R41NFR0G/Microbial-Source-Tracking/Diagrams/diagram of system.png

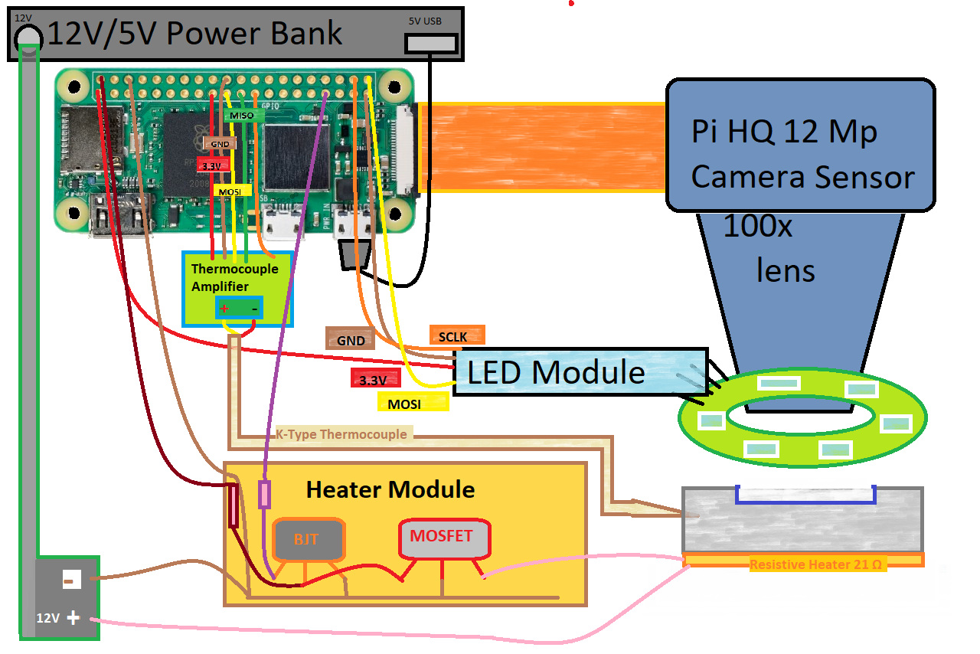
Diagrams/diagram of system.png
