R41NFR0G/Microbial-Source-Tracking/Diagrams/RinglightSchematic.pdf

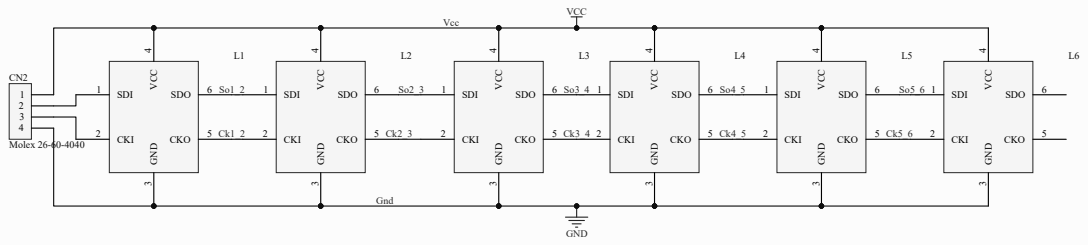
[picture p53: page 1]
Title; Size; Number; Revision; Letter; Date:; Sheet of; File:; led.SchDoc; Drawn By:; SDI 1; CKI 2; GND; CKO; SDO VCC; VCC; Molex 26-60-4040; Vcc; Gnd
