R41NFR0G/Microbial-Source-Tracking/Diagrams/RinglightPCB.pdf

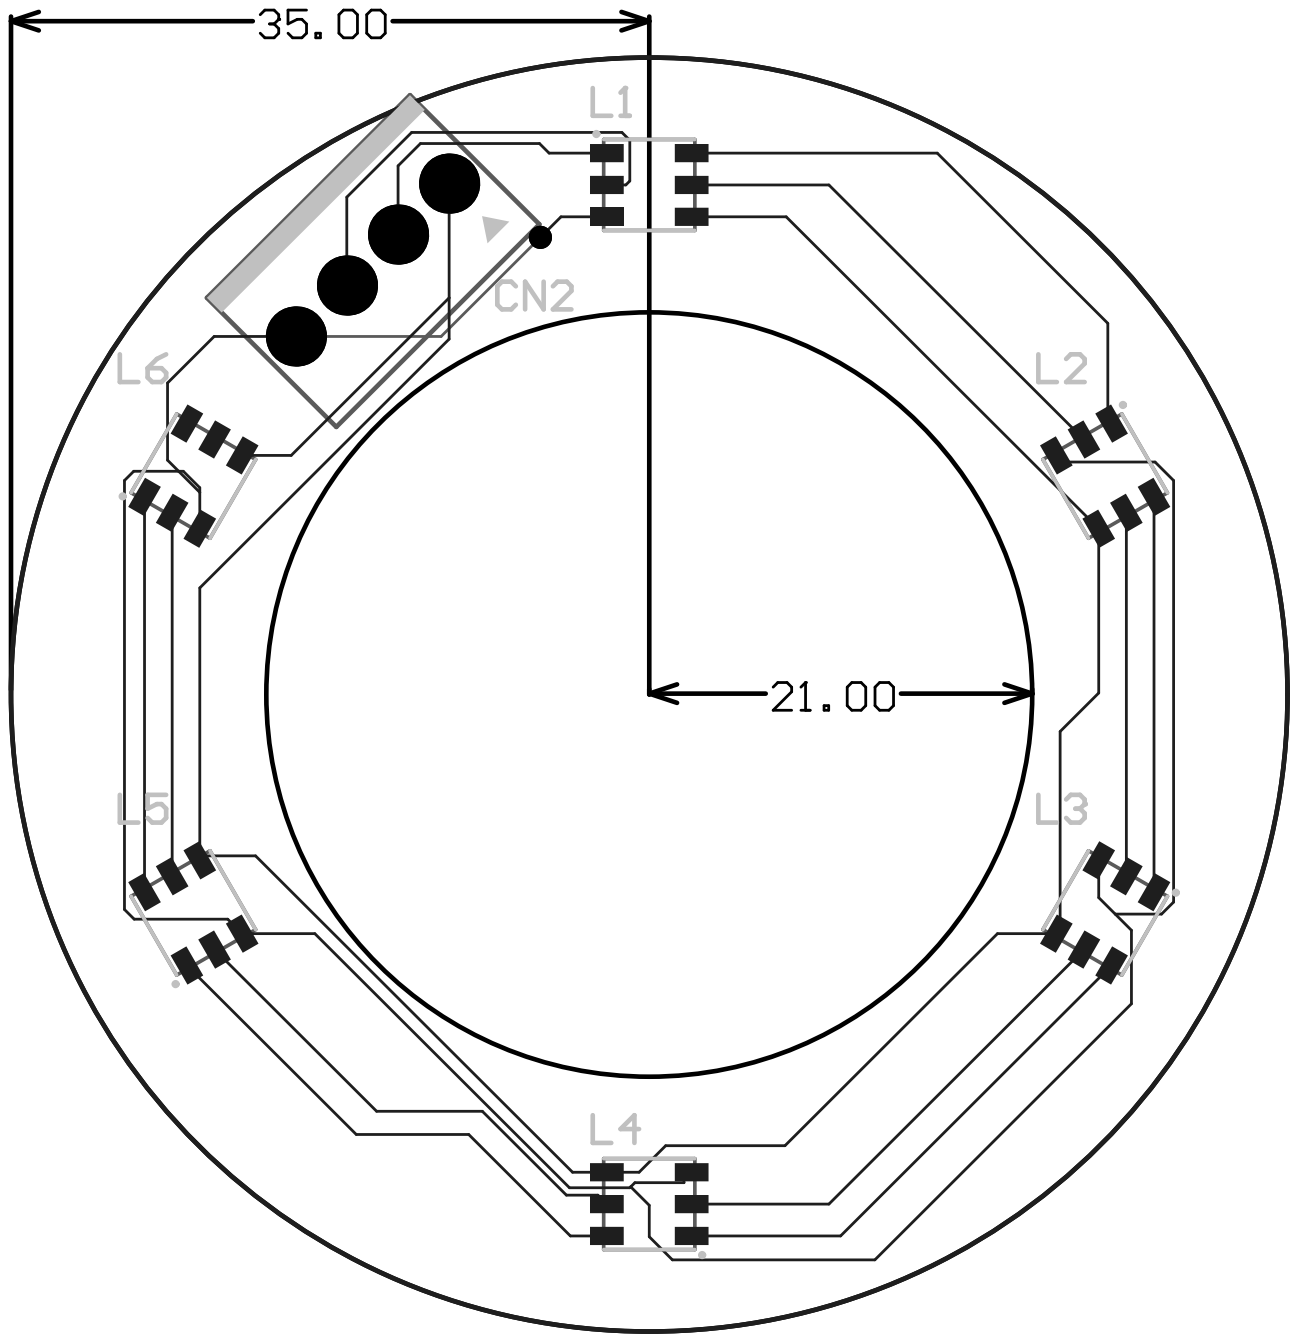
[picture p54: page 1]
