R41NFR0G/Microbial-Source-Tracking/(commit log)

2025-10-20 pcb files
    [PCB1.GBL, PCB1.GBO, PCB1.GBP, PCB1.GBS, PCB1.GM1, PCB1.GTL, PCB1.GTO, PCB1.GTP]
2025-10-20 changed folder name
    [PCB1.GBL, PCB1.GBO, PCB1.GBP, PCB1.GBS, PCB1.GM1, PCB1.GTL, PCB1.GTO, PCB1.GTP]
